Mo-Alaa-Madbouly/Wireless-Master-Slave-5-DoF-Robotic-Arm/Wireless Master-Slave 5 DoF Robotic Arm/CAD/Master Mechanical Design/Effector Assem.SLDASM

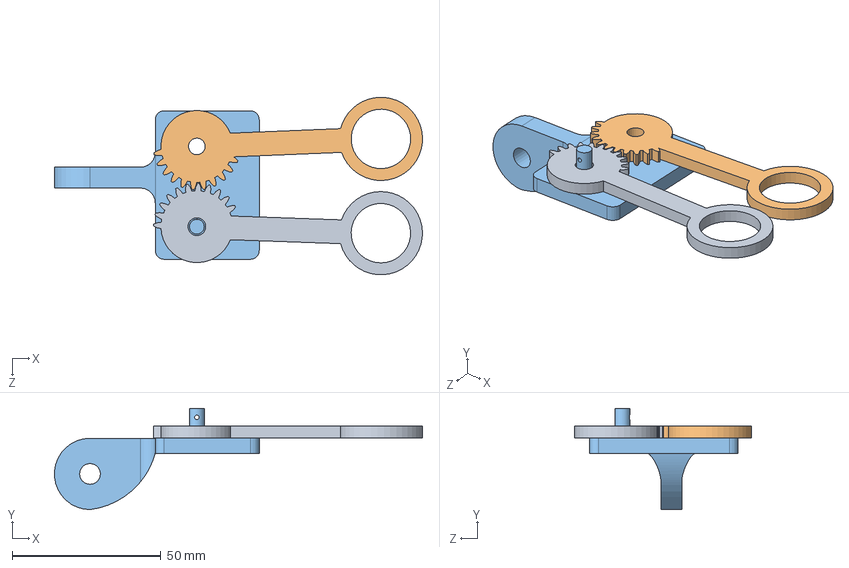
[picture p22: CAD file, 2026-11-11]
Wireless Master-Slave 5 DoF Robotic Arm/CAD/Master Mechanical Design/Effector Assem.SLDASM
123.8 x 34.1 x 59.7 mm
End base
gear1
gear2
