Mo-Alaa-Madbouly/Wireless-Master-Slave-5-DoF-Robotic-Arm/Wireless Master-Slave 5 DoF Robotic Arm/Design Slave/ladle/ladle idea 1.SLDASM

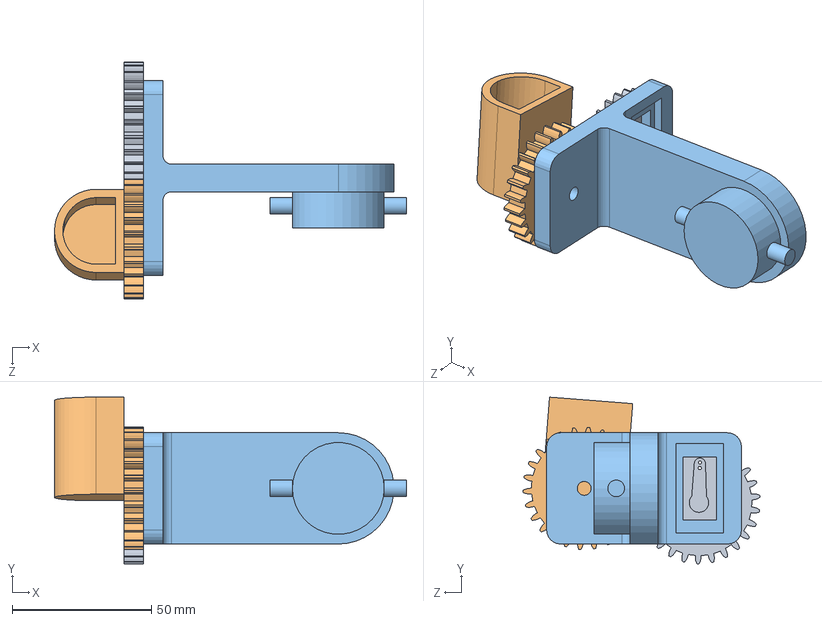
[picture p23: CAD file, 2026-11-05]
Wireless Master-Slave 5 DoF Robotic Arm/Design Slave/ladle/ladle idea 1.SLDASM
126.5 x 59.9 x 85.1 mm
ladle base
ladle
gear
