Mo-Alaa-Madbouly/Wireless-Master-Slave-5-DoF-Robotic-Arm/Wireless Master-Slave 5 DoF Robotic Arm/Design Slave/full assembly.SLDASM

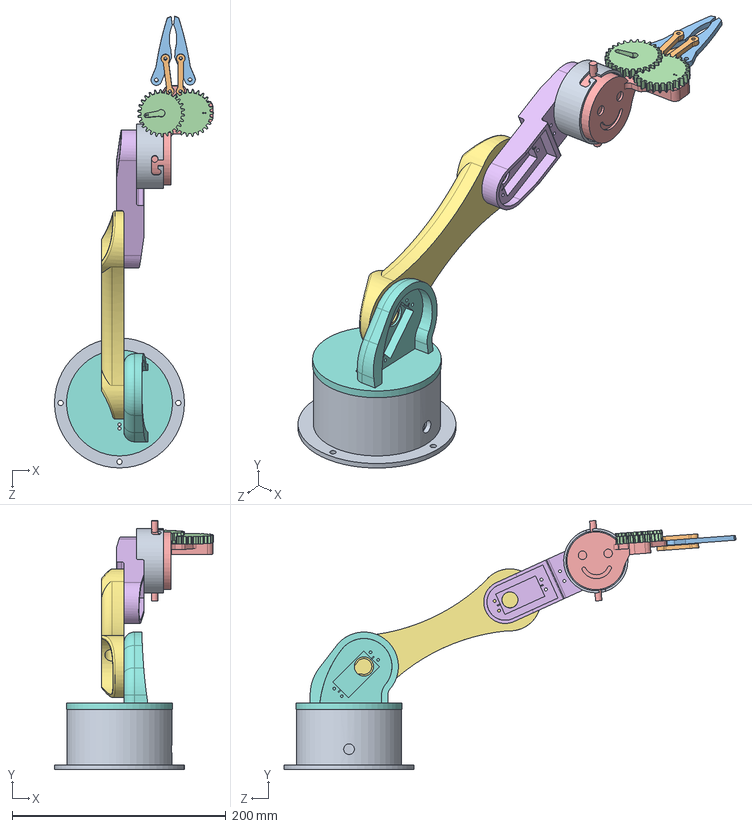
[picture p24: CAD file, 2026-11-05]
Wireless Master-Slave 5 DoF Robotic Arm/Design Slave/full assembly.SLDASM
148.6 x 232.7 x 422.4 mm
base
link 1 last edit
link 2 last edit
last edit link 3
base_gripper
gear x 2
gripper_link_1 x 2
gripper_link_2 x 4
home endeffector mark 2
