Mo-Alaa-Madbouly/Wireless-Master-Slave-5-DoF-Robotic-Arm/Wireless Master-Slave 5 DoF Robotic Arm/CAD/Master Mechanical Design/Assem1.SLDASM

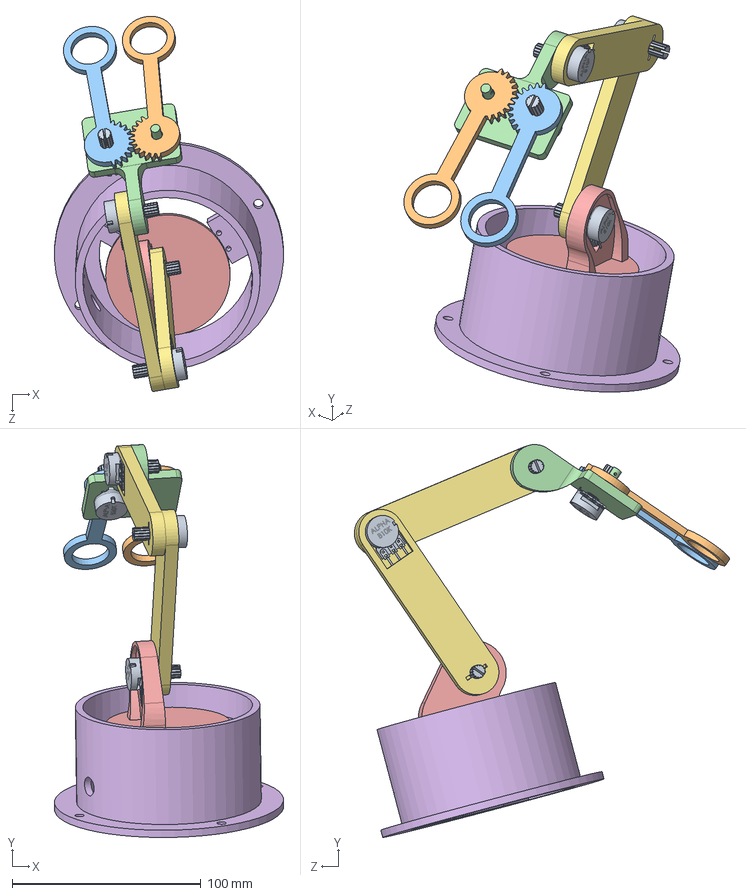
[picture p25: CAD file, 2026-11-11]
Wireless Master-Slave 5 DoF Robotic Arm/CAD/Master Mechanical Design/Assem1.SLDASM
121.4 x 208.3 x 199.0 mm
Base
Waist
End base
gear1
gear2
PotentiometerB10K x 4
