Mo-Alaa-Madbouly/Wireless-Master-Slave-5-DoF-Robotic-Arm/Wireless Master-Slave 5 DoF Robotic Arm/CAD/Design Slave/gripper_link_2.SLDPRT

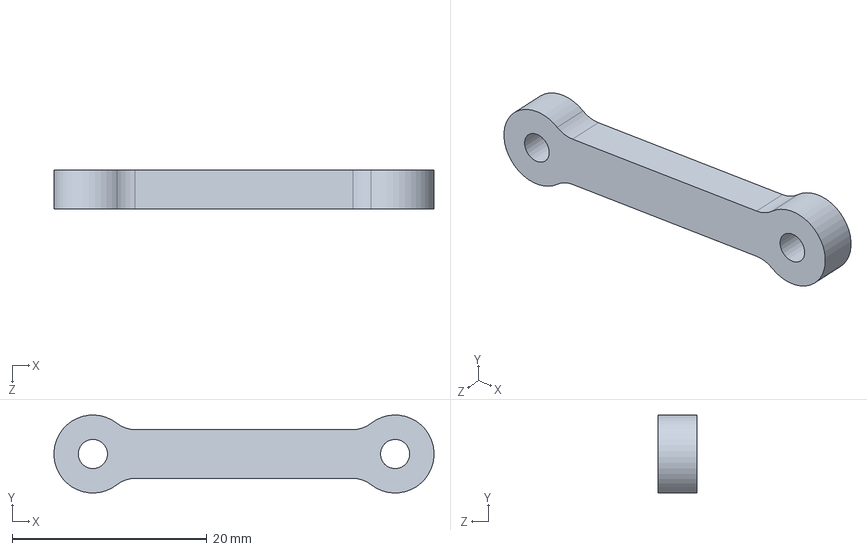
[picture p26: CAD file, 2026-11-11]
Wireless Master-Slave 5 DoF Robotic Arm/CAD/Design Slave/gripper_link_2.SLDPRT
39.0 x 7.99 x 4.00 mm
