Mo-Alaa-Madbouly/Wireless-Master-Slave-5-DoF-Robotic-Arm/Wireless Master-Slave 5 DoF Robotic Arm/CAD/Design Slave/ladle/ladle base.SLDPRT

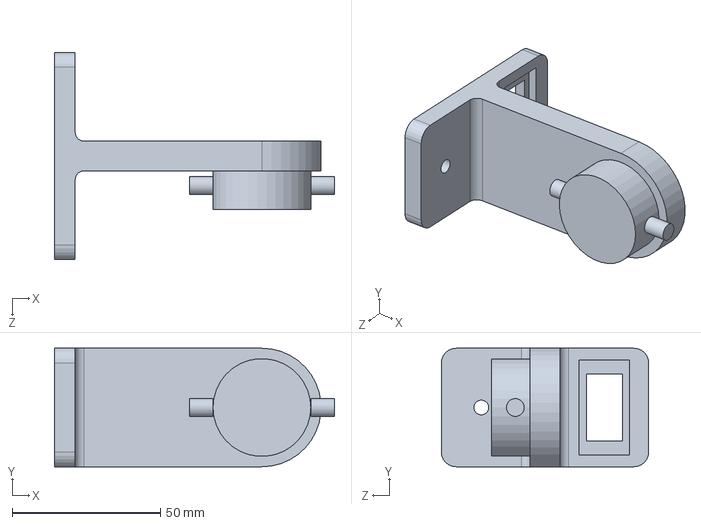
[picture p27: CAD file, 2026-11-11]
Wireless Master-Slave 5 DoF Robotic Arm/CAD/Design Slave/ladle/ladle base.SLDPRT
94.5 x 40.0 x 70.0 mm
