Mo-Alaa-Madbouly/Wireless-Master-Slave-5-DoF-Robotic-Arm/Wireless Master-Slave 5 DoF Robotic Arm/Design Slave/ladle/ladle.SLDPRT

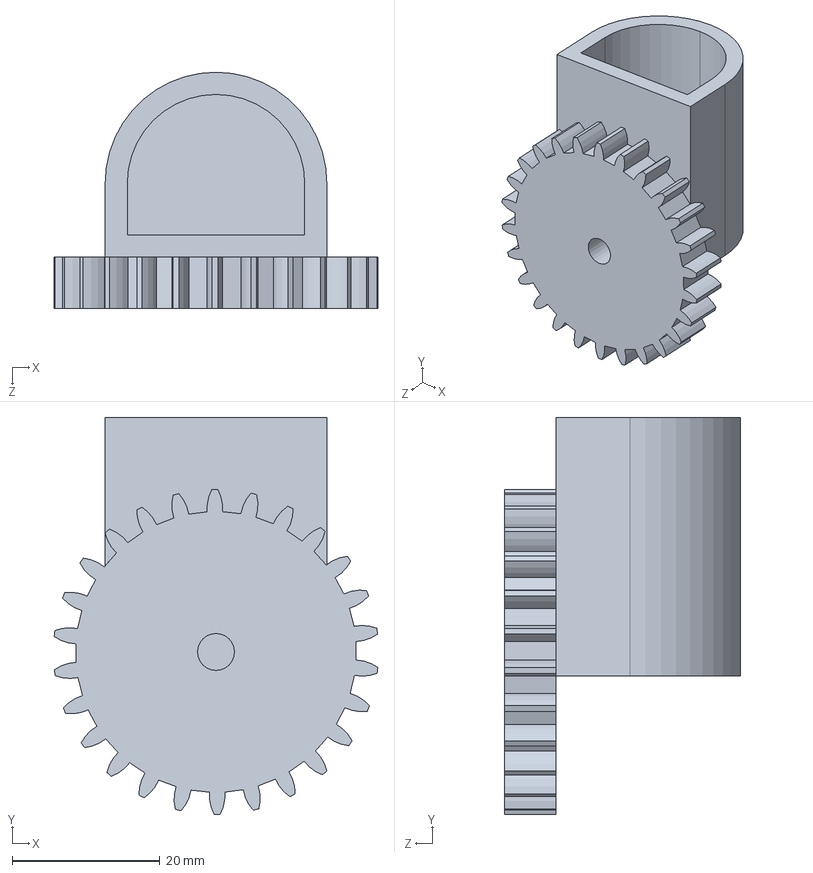
[picture p28: CAD file, 2026-11-05]
Wireless Master-Slave 5 DoF Robotic Arm/Design Slave/ladle/ladle.SLDPRT
43.8 x 53.7 x 32.0 mm
