Mo-Alaa-Madbouly/Wireless-Master-Slave-5-DoF-Robotic-Arm/Wireless Master-Slave 5 DoF Robotic Arm/Design Slave/last edit link 3.SLDPRT

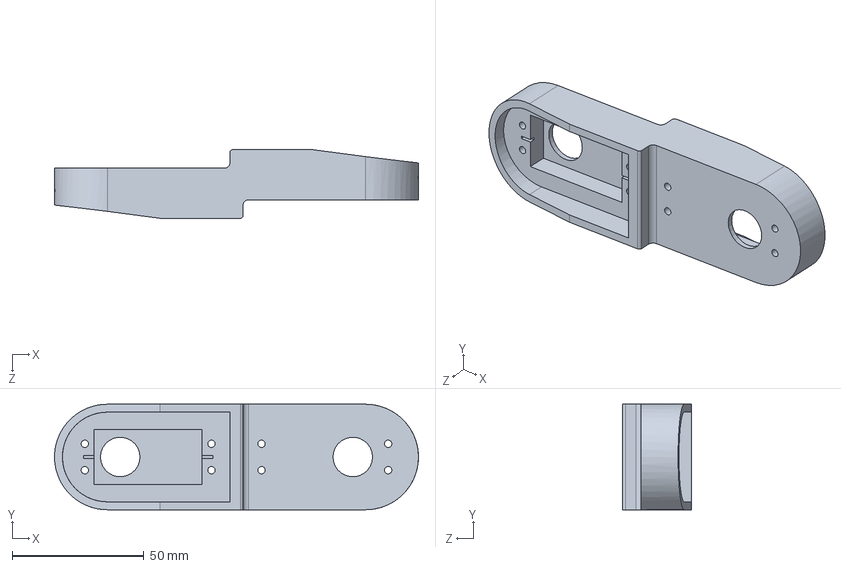
[picture p29: CAD file, 2026-11-05]
Wireless Master-Slave 5 DoF Robotic Arm/Design Slave/last edit link 3.SLDPRT
138.0 x 40.0 x 26.0 mm
