Mo-Alaa-Madbouly/Wireless-Master-Slave-5-DoF-Robotic-Arm/Wireless Master-Slave 5 DoF Robotic Arm/ROS2 workspace/src/jarvis_description/meshes/link2.STL

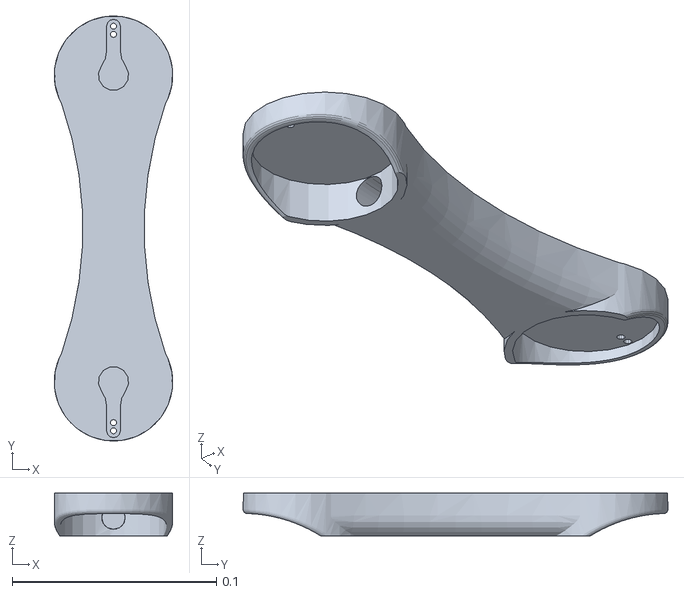
[picture p30: CAD file, 2026-11-06]
Wireless Master-Slave 5 DoF Robotic Arm/ROS2 workspace/src/jarvis_description/meshes/link2.STL
0.058 x 0.208 x 0.021
