Mo-Alaa-Madbouly/Wireless-Master-Slave-5-DoF-Robotic-Arm/Wireless Master-Slave 5 DoF Robotic Arm/CAD/Design Slave/link 2 last edit.SLDPRT

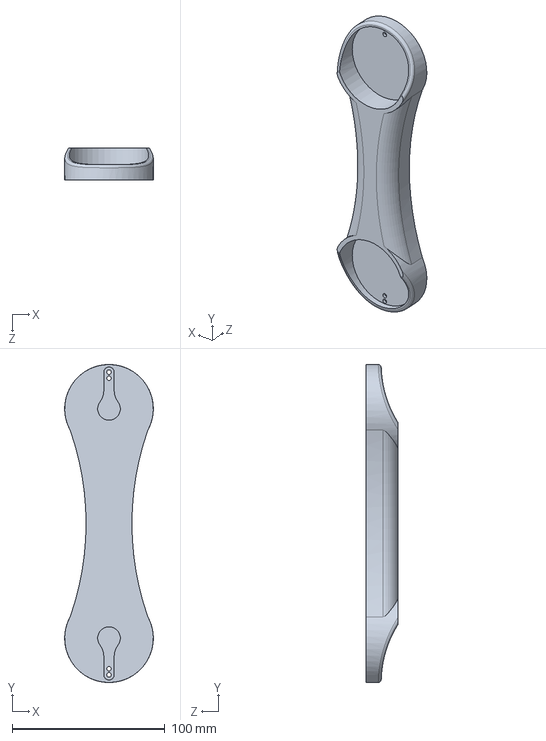
[picture p31: CAD file, 2026-11-11]
Wireless Master-Slave 5 DoF Robotic Arm/CAD/Design Slave/link 2 last edit.SLDPRT
58.0 x 208.0 x 21.0 mm
