Mo-Alaa-Madbouly/Wireless-Master-Slave-5-DoF-Robotic-Arm/Wireless Master-Slave 5 DoF Robotic Arm/CAD/Master Mechanical Design/Part1.SLDPRT

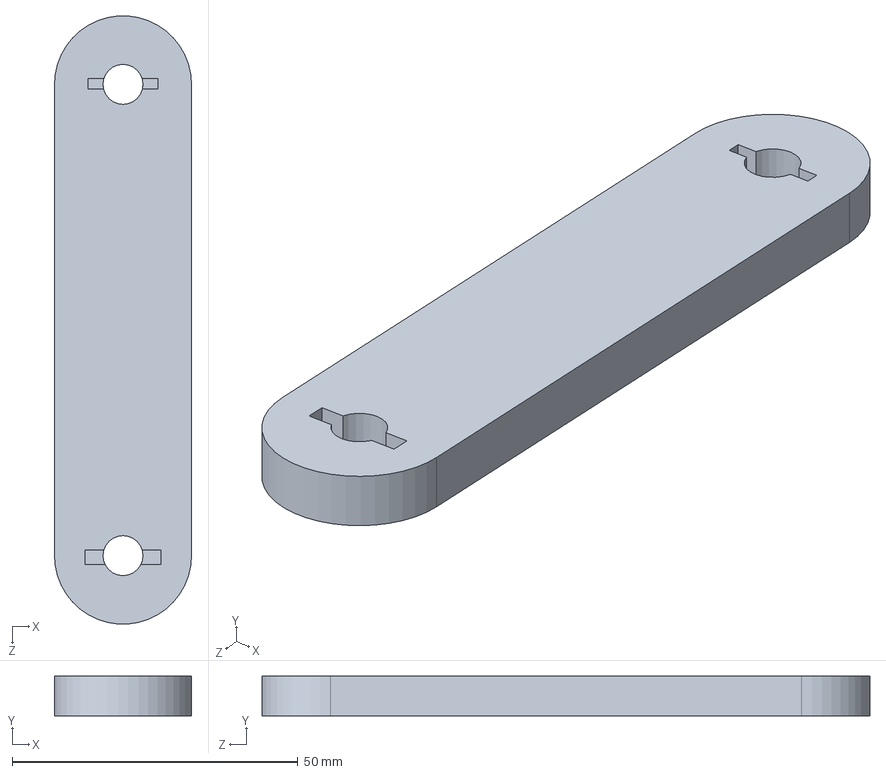
[picture p32: CAD file, 2026-11-11]
Wireless Master-Slave 5 DoF Robotic Arm/CAD/Master Mechanical Design/Part1.SLDPRT
24.0 x 7.00 x 106.4 mm
