Mo-Alaa-Madbouly/Wireless-Master-Slave-5-DoF-Robotic-Arm/Wireless Master-Slave 5 DoF Robotic Arm/Design Slave/ladle/gear.SLDPRT

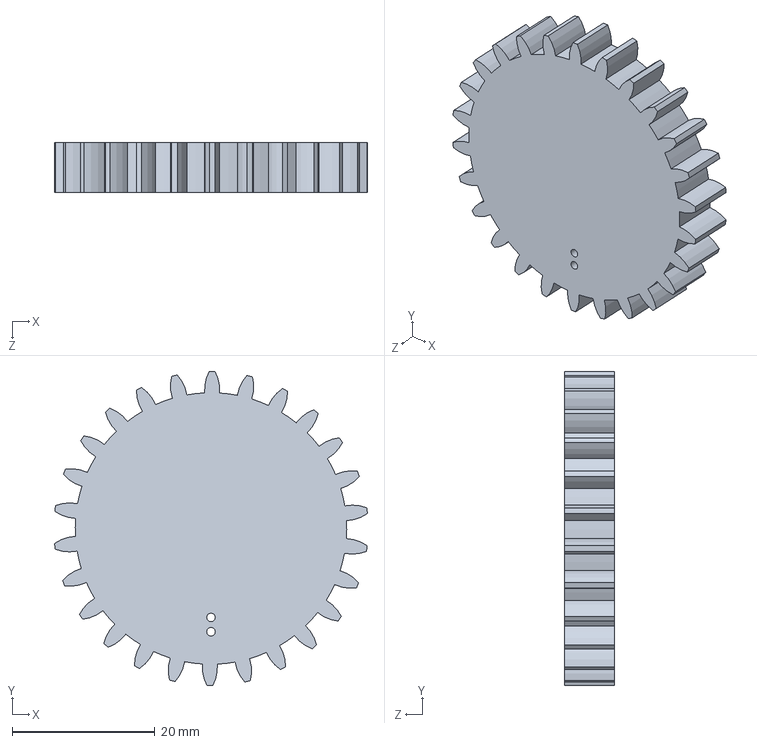
[picture p33: CAD file, 2026-11-05]
Wireless Master-Slave 5 DoF Robotic Arm/Design Slave/ladle/gear.SLDPRT
43.8 x 44.0 x 7.00 mm
