Mo-Alaa-Madbouly/Wireless-Master-Slave-5-DoF-Robotic-Arm/Wireless Master-Slave 5 DoF Robotic Arm/Design Slave/link 1 last edit.SLDPRT

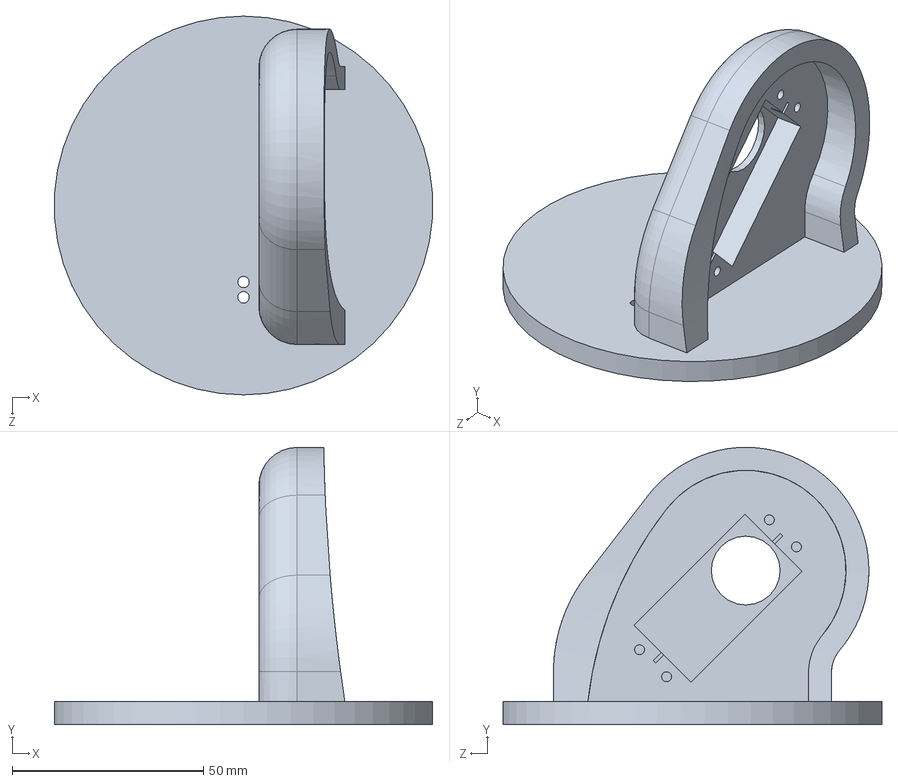
[picture p34: CAD file, 2026-11-05]
Wireless Master-Slave 5 DoF Robotic Arm/Design Slave/link 1 last edit.SLDPRT
98.8 x 72.5 x 99.0 mm
