Mo-Alaa-Madbouly/Wireless-Master-Slave-5-DoF-Robotic-Arm/Wireless Master-Slave 5 DoF Robotic Arm/ROS2 workspace/src/jarvis_description/meshes/link4.STL

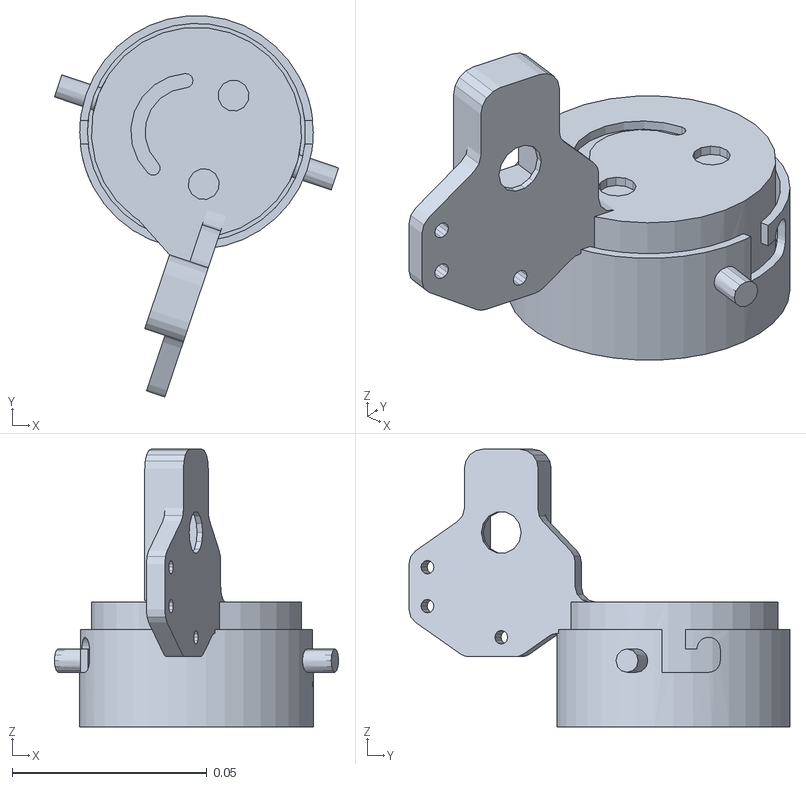
[picture p35: CAD file, 2026-11-06]
Wireless Master-Slave 5 DoF Robotic Arm/ROS2 workspace/src/jarvis_description/meshes/link4.STL
0.073 x 0.0979 x 0.0713
