Mo-Alaa-Madbouly/Wireless-Master-Slave-5-DoF-Robotic-Arm/Wireless Master-Slave 5 DoF Robotic Arm/CAD/Design Slave/home endeffector mark 2.SLDPRT

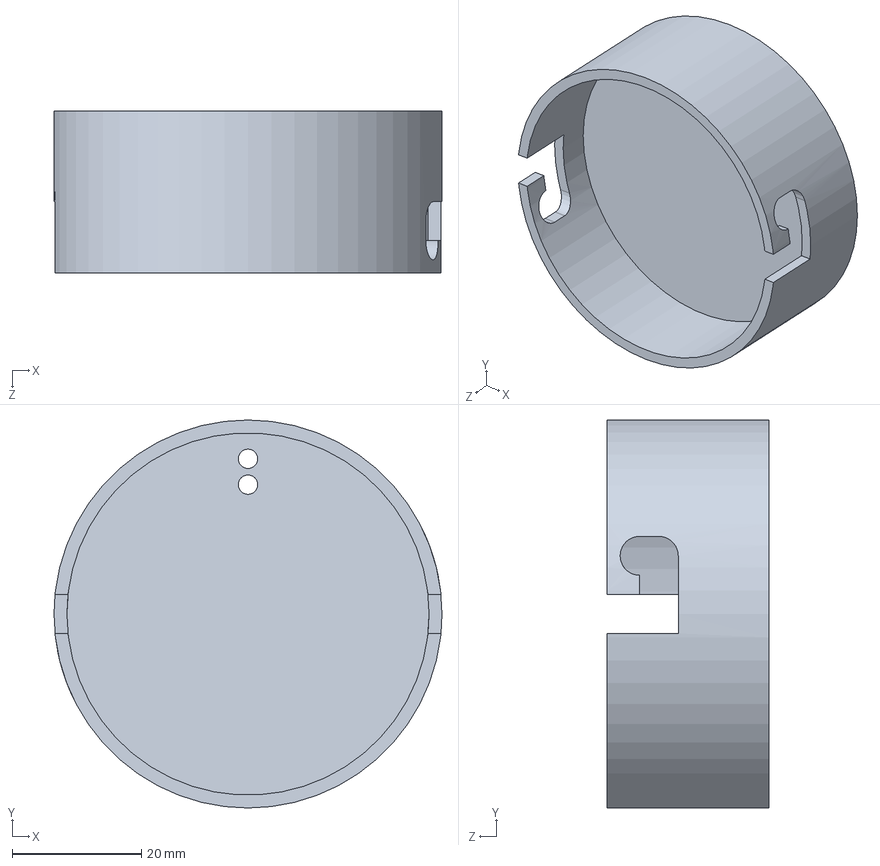
[picture p36: CAD file, 2026-11-11]
Wireless Master-Slave 5 DoF Robotic Arm/CAD/Design Slave/home endeffector mark 2.SLDPRT
60.0 x 60.0 x 25.0 mm
