Mo-Alaa-Madbouly/Wireless-Master-Slave-5-DoF-Robotic-Arm/Wireless Master-Slave 5 DoF Robotic Arm/CAD/Master Mechanical Design/Part2.SLDPRT

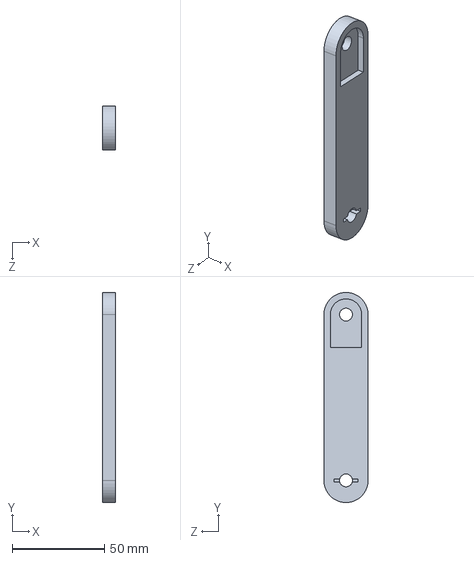
[picture p37: CAD file, 2026-11-11]
Wireless Master-Slave 5 DoF Robotic Arm/CAD/Master Mechanical Design/Part2.SLDPRT
7.00 x 113.9 x 24.0 mm
