Mo-Alaa-Madbouly/Wireless-Master-Slave-5-DoF-Robotic-Arm/Wireless Master-Slave 5 DoF Robotic Arm/ROS2 workspace/src/jarvis_description/meshes/link3.STL

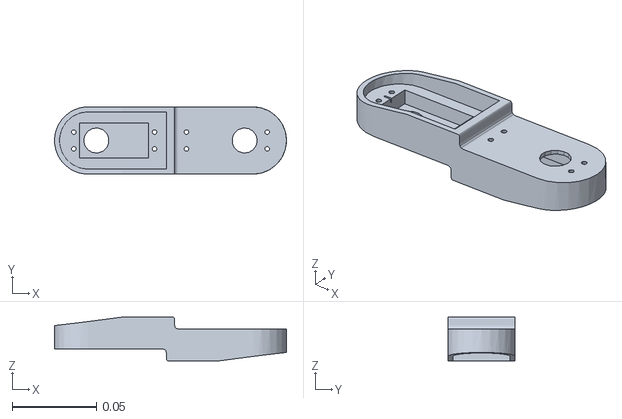
[picture p39: CAD file, 2026-11-06]
Wireless Master-Slave 5 DoF Robotic Arm/ROS2 workspace/src/jarvis_description/meshes/link3.STL
0.138 x 0.04 x 0.026
