Mo-Alaa-Madbouly/Wireless-Master-Slave-5-DoF-Robotic-Arm/Wireless Master-Slave 5 DoF Robotic Arm/CAD/Master Mechanical Design/gear1.SLDPRT

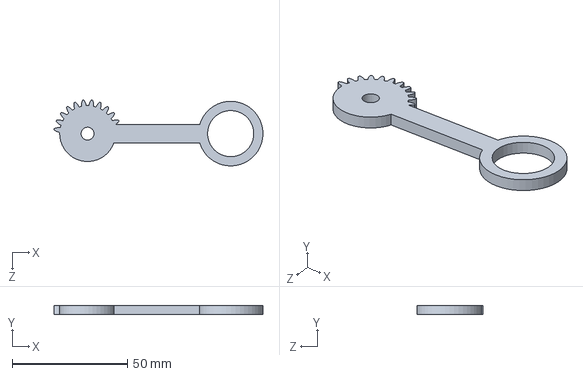
[picture p40: CAD file, 2026-11-11]
Wireless Master-Slave 5 DoF Robotic Arm/CAD/Master Mechanical Design/gear1.SLDPRT
90.5 x 4.00 x 28.5 mm
