Mo-Alaa-Madbouly/Wireless-Master-Slave-5-DoF-Robotic-Arm/Wireless Master-Slave 5 DoF Robotic Arm/ROS2 workspace/src/jarvis_description/meshes/link1.STL

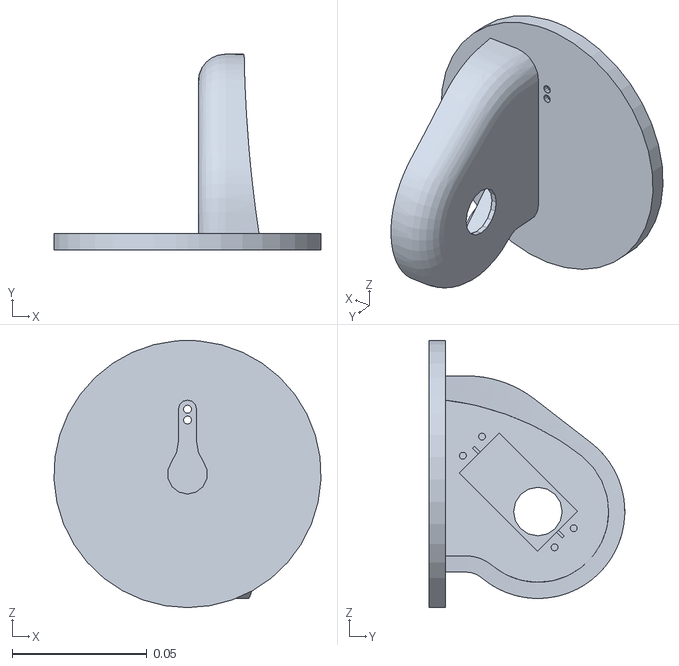
[picture p41: CAD file, 2026-11-06]
Wireless Master-Slave 5 DoF Robotic Arm/ROS2 workspace/src/jarvis_description/meshes/link1.STL
0.0989 x 0.0725 x 0.099
