Mo-Alaa-Madbouly/Wireless-Master-Slave-5-DoF-Robotic-Arm/Wireless Master-Slave 5 DoF Robotic Arm/CAD/Master Mechanical Design/PotentiometerB10K.SLDPRT

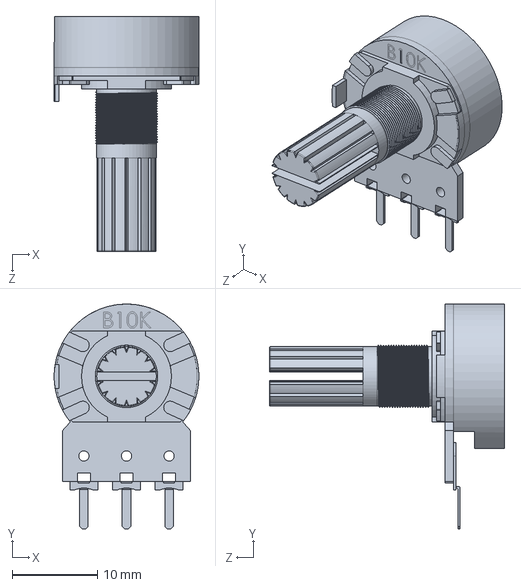
[picture p42: CAD file, 2026-11-11]
Wireless Master-Slave 5 DoF Robotic Arm/CAD/Master Mechanical Design/PotentiometerB10K.SLDPRT
17.0 x 26.4 x 27.6 mm
