Mo-Alaa-Madbouly/Wireless-Master-Slave-5-DoF-Robotic-Arm/Wireless Master-Slave 5 DoF Robotic Arm/ROS2 workspace/src/jarvis_description/meshes/link5.STL

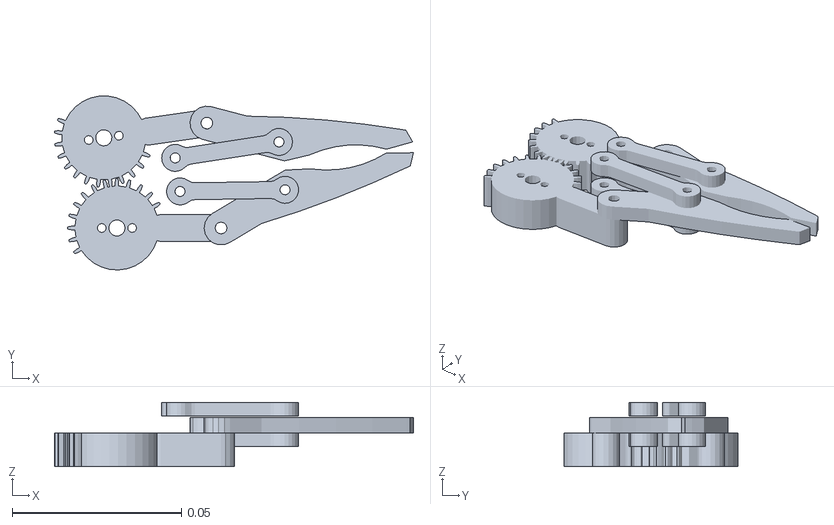
[picture p44: CAD file, 2026-11-06]
Wireless Master-Slave 5 DoF Robotic Arm/ROS2 workspace/src/jarvis_description/meshes/link5.STL
0.106 x 0.0514 x 0.019
