Mo-Alaa-Madbouly/Wireless-Master-Slave-5-DoF-Robotic-Arm/Wireless Master-Slave 5 DoF Robotic Arm/Design Slave/gripper_link_1.SLDPRT

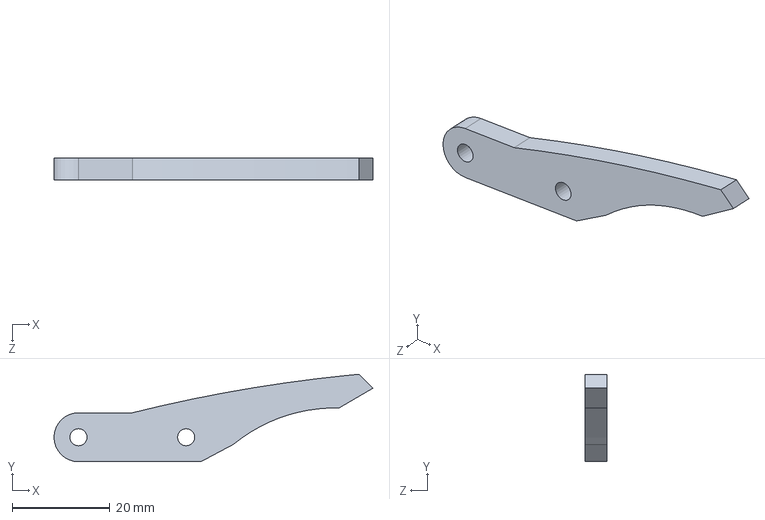
[picture p46: CAD file, 2026-11-05]
Wireless Master-Slave 5 DoF Robotic Arm/Design Slave/gripper_link_1.SLDPRT
65.2 x 17.9 x 4.50 mm
