Mo-Alaa-Madbouly/Wireless-Master-Slave-5-DoF-Robotic-Arm/Wireless Master-Slave 5 DoF Robotic Arm/Design Slave/base_gripper.SLDPRT

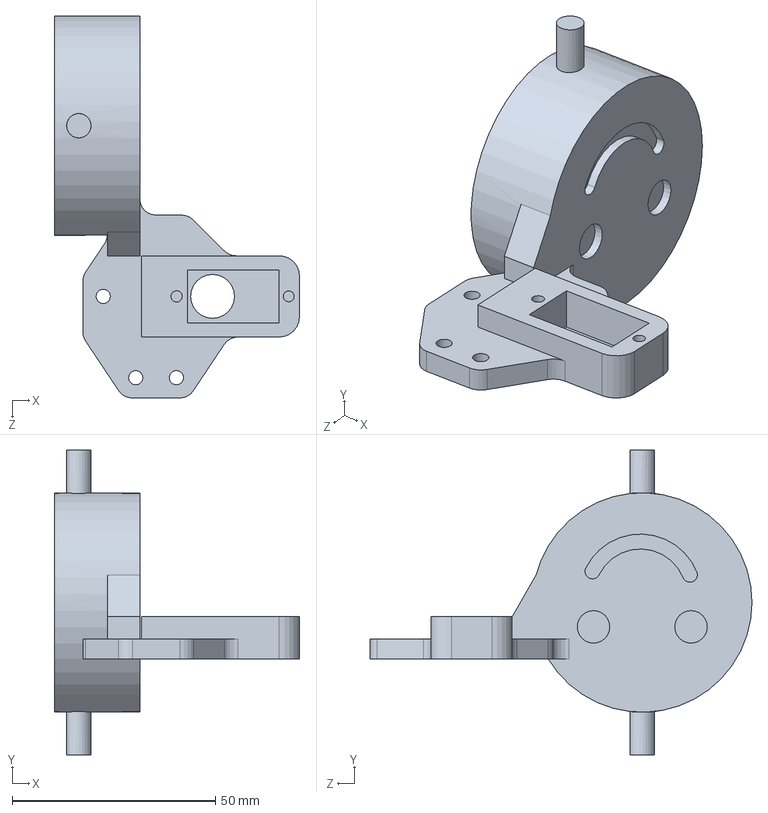
[picture p49: CAD file, 2026-11-05]
Wireless Master-Slave 5 DoF Robotic Arm/Design Slave/base_gripper.SLDPRT
60.3 x 75.0 x 94.0 mm
