Mo-Alaa-Madbouly/Wireless-Master-Slave-5-DoF-Robotic-Arm/Wireless Master-Slave 5 DoF Robotic Arm/Wiring Diagram/Wiring Diagram.png

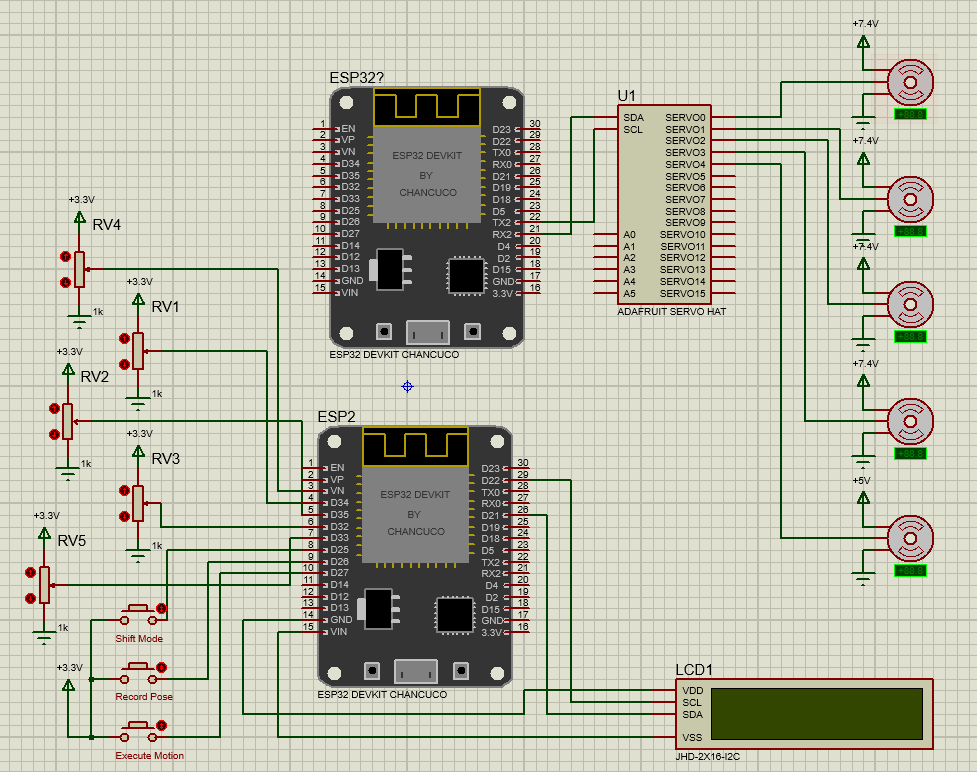
Wireless Master-Slave 5 DoF Robotic Arm/Wiring Diagram/Wiring Diagram.png
