Mo-Alaa-Madbouly/Wireless-Master-Slave-5-DoF-Robotic-Arm/Wireless Master-Slave 5 DoF Robotic Arm/ROS2 workspace/src/jarvis_moveit_config/config/initial_positions.yaml

# Default initial positions for jarvis's ros2_control fake system

initial_positions:
  joint1: 0
  joint2: 0
  joint3: 0
  joint4: 0
  joint5: 0
