Mo-Alaa-Madbouly/Wireless-Master-Slave-5-DoF-Robotic-Arm/(commit log)

2026-11-05 Add Slave Robotic arm CAD Files
2026-11-11 Add Master CAD Files
2026-11-11 Revise README with project details and features
    Updated project title and added detailed overview and features of the wireless master-slave robotic arm. Enhanced documentation structure and clarified system architecture.
